vector-collective/ai-wearable/README.md

# ai-wearable

A chest-worn pendant that captures the wearer's conversations, learns who
they are talking to, and feeds a pipeline that reports on the wearer's own
conduct and mood — per relationship, over time. Personal use, one wearer.

| | |
|---|---|
| [`docs/SPEC.md`](docs/SPEC.md) | what it does and how the pieces split — read this first |
| [`firmware/`](firmware/) | XIAO ESP32S3 Sense: three mics, camera, SD, BLE; the capture side |
| [`hardware/`](hardware/) | two enclosures — a resin-printed medallion and a sewn leather pouch |
| [`pipeline/`](pipeline/) | the server side: diarization, transcription, analysis, approval queue (scaffold) |

The pendant captures and triggers; a phone relays; a home server thinks. The
split is forced by the microcontroller, and the hybrid new-voice trigger in
the spec is what lets the whole thing degrade rather than die when any link
in that chain is slow or gone.

## Firmware tests

Host-side, no toolchain needed:

```
bash firmware/test/run.sh
```

Covers the mic source selection, the case UI state machine, photo upload
pacing, the burst policy, time sync, the event ring, the high-pass and
filterbank, the own-voice gate and new-voice detector against synthetic
voices, and the thermal policy. The firmware itself
builds with PlatformIO (`firmware/platformio.ini`).
