vector-collective/ai-wearable/hardware/medallion/renders/face.png

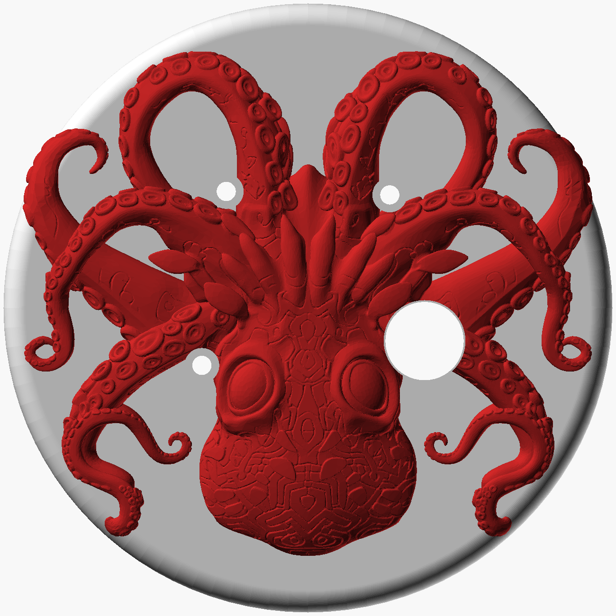
hardware/medallion/renders/face.png
