vector-collective/ai-wearable/hardware/medallion/renders/iso.png

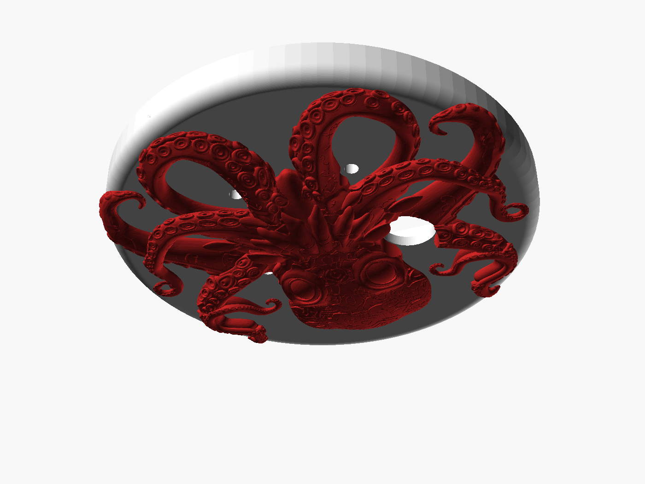
hardware/medallion/renders/iso.png
