vector-collective/ai-wearable/hardware/medallion/renders/rim.png

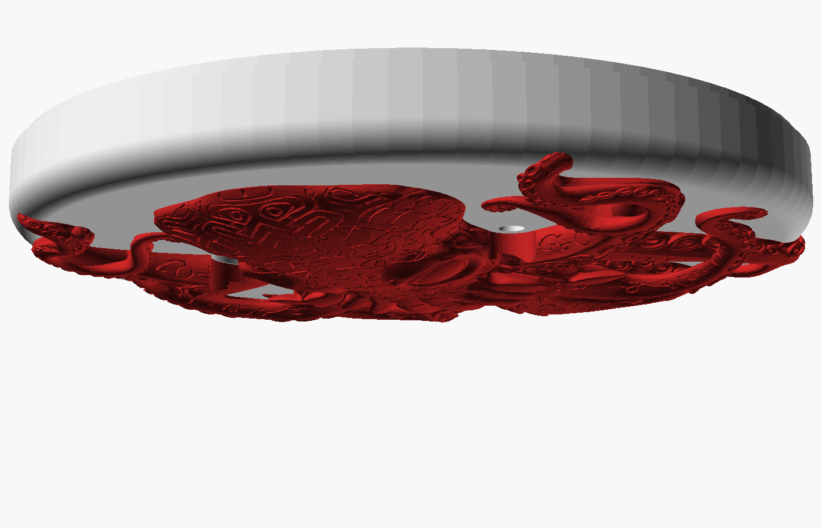
hardware/medallion/renders/rim.png
