vector-collective/ai-wearable/hardware/medallion/renders/toroid_detail.png

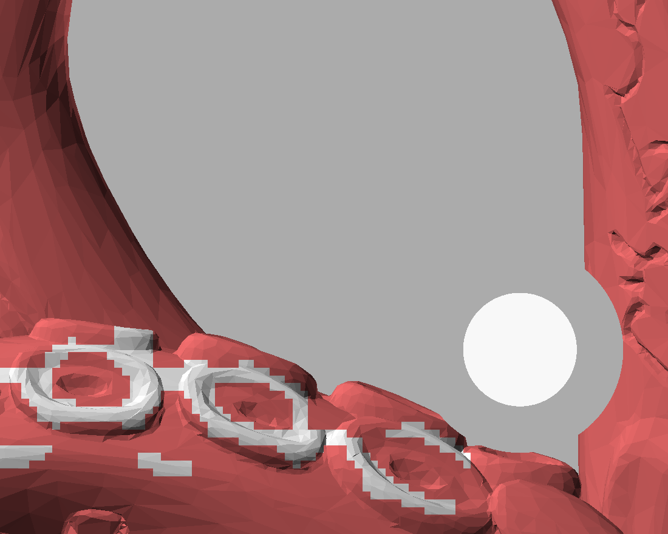
hardware/medallion/renders/toroid_detail.png
