vector-collective/ai-wearable/hardware/medallion/renders/v9_back_ears.png

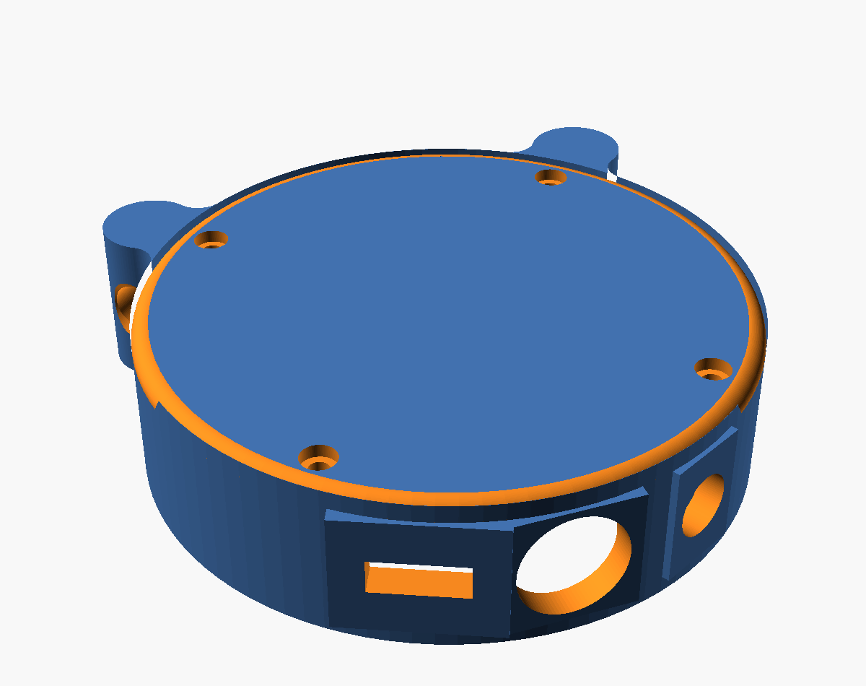
hardware/medallion/renders/v9_back_ears.png
