vector-collective/ai-wearable/hardware/medallion/renders/v9_ear_hole.png

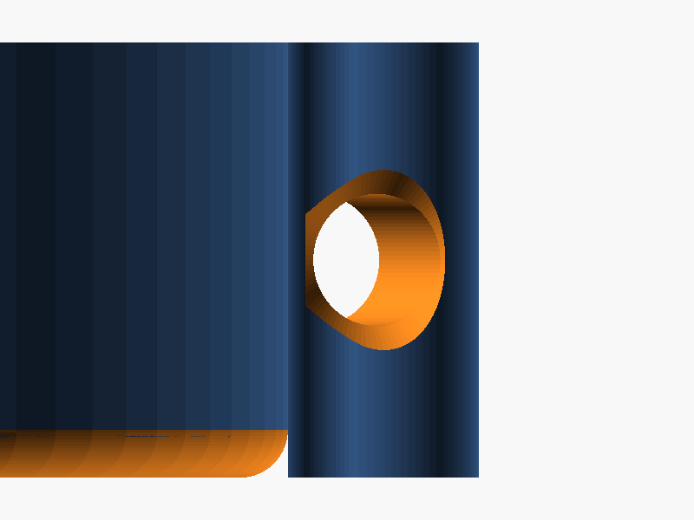
hardware/medallion/renders/v9_ear_hole.png
