vector-collective/ai-wearable/hardware/pouch/renders/worn.png

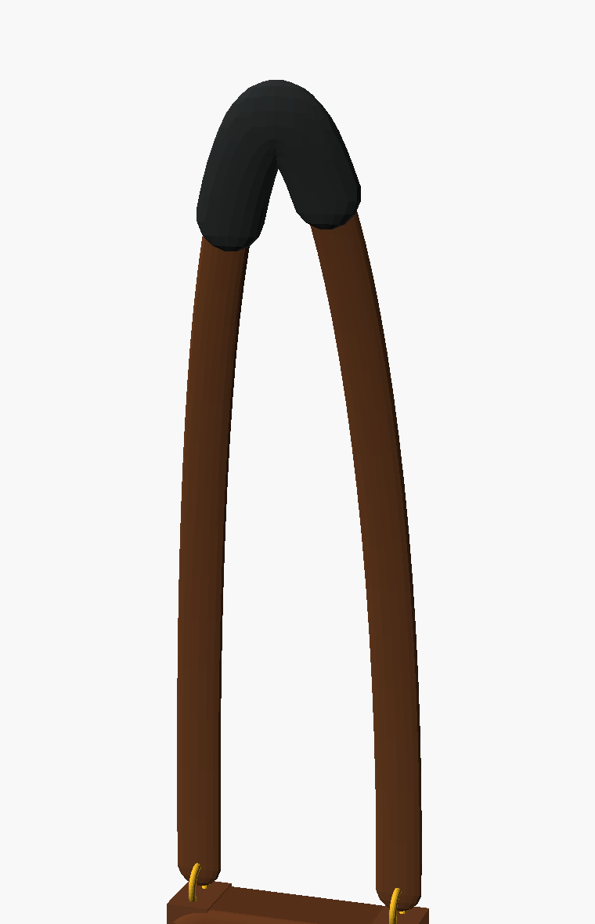
hardware/pouch/renders/worn.png
