vector-collective/ai-wearable/hardware/medallion/front_fused.stl

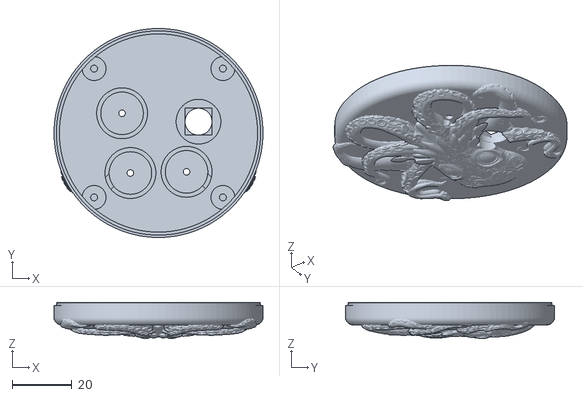
[picture p12: CAD file, 2026-09-10]
hardware/medallion/front_fused.stl
70.0 x 70.0 x 12.1
