vector-collective/ai-wearable/hardware/pouch/template.dxf

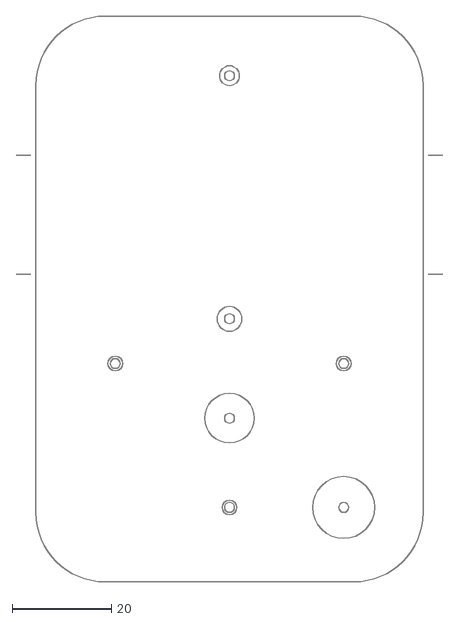
[picture p13: CAD file, 2026-09-06]
hardware/pouch/template.dxf
86.0 x 114.0
