vector-collective/ai-wearable/hardware/medallion/back_shell.stl

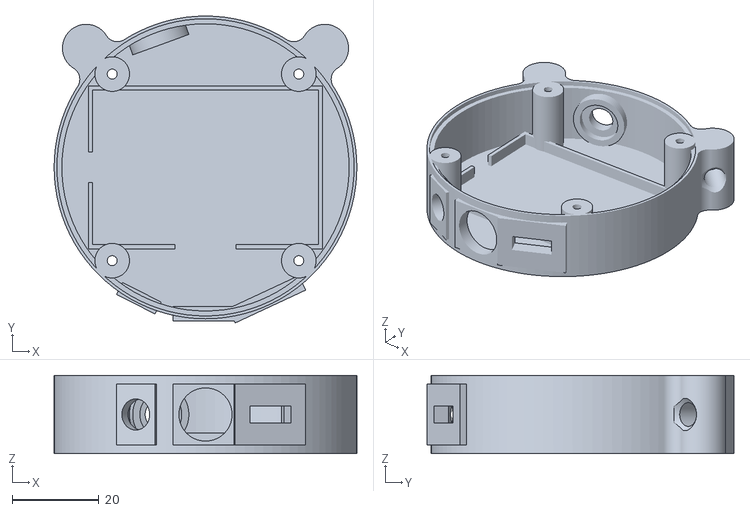
[picture p14: CAD file, 2026-09-10]
hardware/medallion/back_shell.stl
70.0 x 71.0 x 18.1
