vector-collective/ai-wearable/hardware/medallion/front_shell.stl

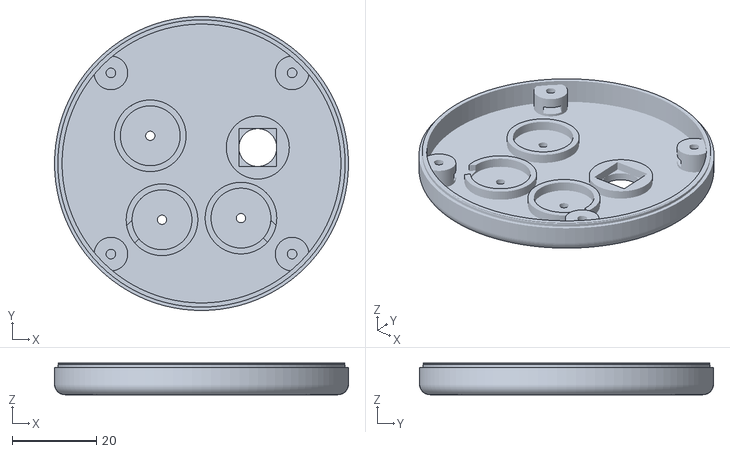
[picture p15: CAD file, 2026-09-10]
hardware/medallion/front_shell.stl
70.0 x 70.0 x 7.50
