vector-collective/ai-wearable/hardware/medallion/kraken_accents.stl

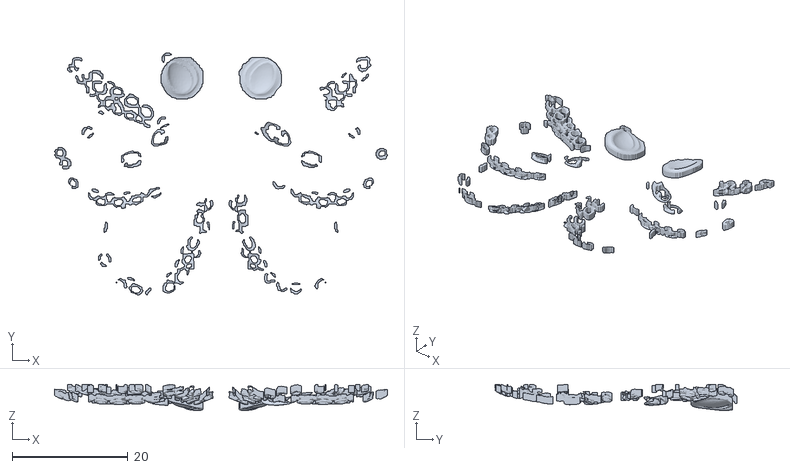
[picture p16: CAD file, 2026-09-04]
hardware/medallion/kraken_accents.stl
57.6 x 41.8 x 4.52
