vector-collective/ai-wearable/hardware/medallion/kraken_body.stl

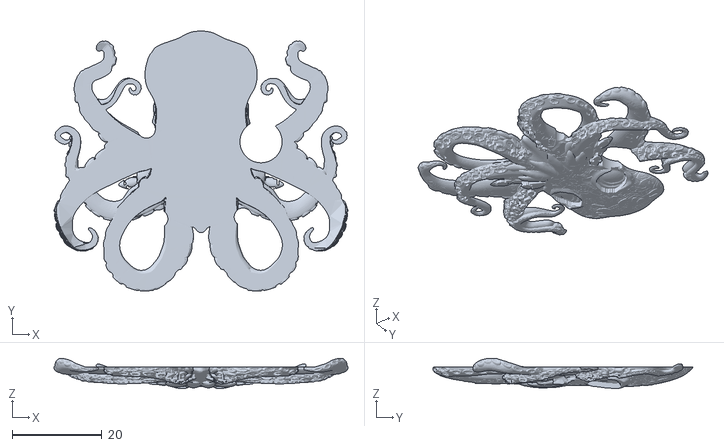
[picture p17: CAD file, 2026-09-04]
hardware/medallion/kraken_body.stl
65.6 x 58.0 x 6.77
