vector-collective/ai-wearable/hardware/medallion/kraken_wrap_bored.stl

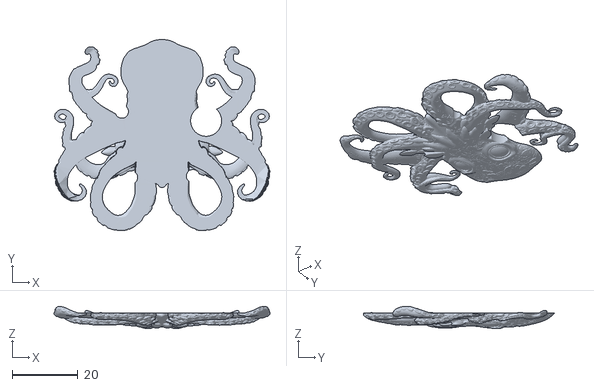
[picture p18: CAD file, 2026-09-04]
hardware/medallion/kraken_wrap_bored.stl
65.6 x 58.0 x 6.77
