vector-collective/ai-wearable/(list of files, cad)

Other CAD files:
hardware/medallion/pendant_case_v7.scad
hardware/medallion/pendant_case_v8.scad
