vector-collective/ai-wearable/hardware/medallion/renders/v9_assembled.png

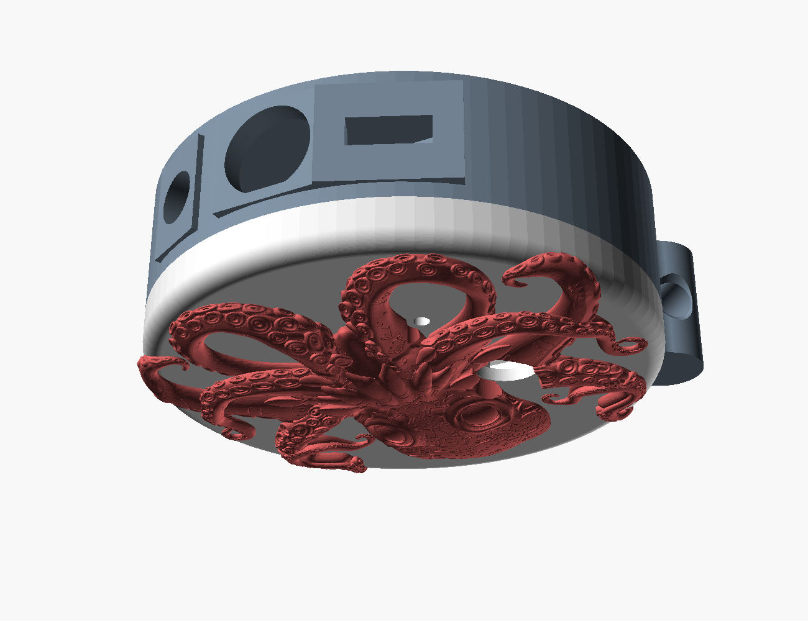
hardware/medallion/renders/v9_assembled.png
