vector-collective/ai-wearable/firmware/src/burst.h

#ifndef BURST_H
#define BURST_H

#include <stddef.h>
#include <stdint.h>

// New-voice photo burst controller. Owns the policy (burst_logic.h), parses
// the CAPTURE_CTRL characteristic, and asks the recorder for frames.

void burst_init();
void burst_loop(uint32_t now);                          // expires hold-offs

// CAPTURE_CTRL write. Ops are in docs/SPEC.md section 3.1.
void burst_handle_ctrl(const uint8_t *data, size_t len);

// The device-tier detector's hook (mic.cpp's novelty detector, via app.cpp).
// score: distance in dB x10 to the nearest known voice, -10 if none known.
// Arms the hold-off; logs EV_CANDIDATE when it does.
void burst_local_candidate(uint32_t hint, int16_t score);

// Thermal hold: no bursts start while set (thermal.h WARM and above).
void burst_set_hold(bool hold);

bool burst_quiet();

#endif // BURST_H
