vector-collective/ai-wearable/(commit log)

2026-08-19 Add quad-INMP441 belt-device firmware (patched omiGlass)
    Patch BasedHardware omiGlass firmware (@1cc793ce2ec9, MIT) for the
    belt-worn capture device: replace the XIAO Sense onboard PDM mic with
    four INMP441s on two standard-mode I2S buses, add per-block source
    selection (optional lapel wins while live, else loudest case mic with
    hysteresis), hot-pluggable lapel via data-line pulldown detection, and
    serial logging of levels and source changes. Opus/BLE pipeline and Omi
    protocol untouched; only src/mic.cpp and src/config.h differ from
    upstream (see firmware/patches/quad-inmp441.patch).
    Claude-Session: https://claude.ai/code/session_012BhN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
    [partitions_ota.csv]
2026-08-19 Add host-side logic tests for mic source selection
    Stub Arduino/I2S/GPIO headers let mic.cpp compile and run on any host
    with plain g++ (./firmware/test/run.sh). Covers channel selection,
    switch hysteresis, lapel takeover and 5s hold-then-fallback, rear-mic
    selection, saturation clamping, and bus-1 failure degradation.
    Claude-Session: https://claude.ai/code/session_012BhN3LnMNn6HhZgrXinjJS
2026-08-22 Add case UI (RGB LED + button) and SD video/audio recorder
    Button state machine: idle short press = battery check shown on a WS2812
    RGB LED (cool-to-warm charge spectrum, red = almost dead); idle long
    press starts recording (start blink doubles as a battery readout);
    short press while recording logs a bookmark and splits the segment;
    long press stops with a double blink colored by SD free space.
    Recorder writes JPEG frames + per-segment WAV with crash-safe header
    patching and a bookmarks.csv to session folders on the Sense microSD.
    Mic bus 0 moves to D5/D6/D7 (GPIO6/43/44) because GPIO7/8/9 are
    hardwired to the SD slot; WS2812 data and the battery divider share
    GPIO2. Status LED writes are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
    [app.cpp, app.h, config.h, recorder_util.h, sd_recorder.cpp, sd_recorder.h]
2026-08-22 Raise record long-press to 1.5s as a guarded control
    Recording is a deliberate, rarely-used function on a small stiff button;
    a 1.5s hold makes accidental starts from furniture or clothing contact
    effectively impossible.
    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
    [config.h]
2026-08-22 Fix audio-path stalls, battery gauge, and bus-1 dropout handling
    From a firmware review pass:
    - Camera fb_count 1 -> 2 and skip recorder grabs while the BLE photo path
    holds a buffer. With one buffer an in-flight photo upload made every
    recorder grab block on the camera's 4s acquire timeout, killing audio.
    - I2S DMA depth 4 -> 12 buffers (~190ms). At 4 the ring held 64ms, less
    than the 100ms read block, so any SD or BLE stall dropped samples.
    - readBatteryLevel: drop 100ms of delay() from the audio path, read via
    analogReadMilliVolts (picks up eFuse ADC calibration), and apply this
    build's 2:1 divider instead of the inherited 6.086 ratio, which pinned
    the reported battery level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
    [app.cpp, app.h, config.h, mic.cpp, recorder_util.h, sd_recorder.cpp, ui.cpp]
2026-08-22 Separate LED and battery-ADC pins; drop the expansion base
    An electrical review found the Seeed Expansion Board Base is not a passive
    battery holder: it hardwires a buzzer to A3, a user button to D1, an
    OLED/RTC I2C bus to D4/D5 and its own microSD chip-select to D2, which
    collides with the LED node and all of mic bus 1. It was only ever in the
    design to avoid soldering the battery; the battery now solders to the
    XIAO's own B+/B- pads and the base is gone.
    Sharing GPIO2 between the WS2812 data line and the battery divider was
    also unsound - with the pad in ADC mode the divider holds the LED's data
    input at VBAT/2, dead centre of its forbidden band, so the latched colour
    was undefined. The d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
    [app.cpp, config.h, ui.cpp]
2026-08-22 Split always-on audio from toggled video; raise camera quality
    Architecture per the agreed model: audio capture and BLE transcription run
    unconditionally from boot and are never gated by the button. The button
    toggles a video session, and audio is written to SD only while one is
    running, so the two can be joined afterwards.
    - Recorder moves into its own FreeRTOS task fed by a stream buffer. Camera
    grabs and SD writes routinely stall for 100-500ms; they can no longer
    block audio capture. Dropped audio bytes are counted and reported at
    session end rather than lost silently.
    - Camera is initialized on session start and deinitialized on stop, so it
    costs nothing during always-on audio.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
    [app.cpp, app.h, config.h, mic.cpp, sd_recorder.cpp, sd_recorder.h, ui.cpp]
2026-08-22 Refresh docs to match current design; add CI
    - Regenerate patches/quad-inmp441.patch against upstream: it covered only
    the original two-file mic patch and now spans all 11 changed files.
    - README: rewrite the header and change summary around the always-on audio
    / toggled video split, the recorder task, and the camera lifecycle; note
    that the camera is untouched at boot.
    - config.h: drop the inherited '6-8 hours' framing and document why the
    light-sleep path is unreachable and deliberately left that way (it would
    gate APB out from under a running I2S peripheral).
    - mic.cpp: header comment now states the selection order and why case
    changeover is gated to near-silence.
    - Add GitHub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
2026-08-22 Use the full 8MB flash; drop dead header; de-duplicate CI runs
    The first real cross-compile (CI) reported Flash at 95.5% - 83kB of
    headroom. The cause was the inherited partition table, which allocated
    only the first 4MB of the board's 8MB flash and so capped each OTA slot at
    1.75MB. The table now spans the whole chip: 3.625MB per app slot and 704kB
    of SPIFFS, taking the firmware to roughly 46% of its partition. Flash size
    is stated explicitly in both build environments.
    Also removes src/camera_index.h - 154kB of upstream camera-web-UI source
    that nothing includes (it was dead source, not dead flash) - and stops the
    CI workflow running twice per push by triggering on master pushes plus
    pull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
    [partitions_ota.csv]
2026-08-22 Short press stops capture; compile out the lapel path entirely
    Button semantics per the agreed scheme: idle short press = battery
    readout, idle long press (1.5s) = start AV capture, and EITHER press
    while recording stops it. Previously a short press while recording
    logged a bookmark and split the segment; that gesture is now stop, so
    the bookmark/segment-split path is removed along with bookmarks.csv.
    Long-press-while-recording also stops rather than being a dead gesture -
    starting remains the guarded action, ending does not need to be.
    The LED stays off except while showing a readout, which was already the
    behavior and is now stated in the README.
    Phase 1 ships without the lapel pod, so M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
    [mic.cpp, sd_recorder.cpp, sd_recorder.h, ui.cpp, ui_logic.h]
2026-08-22 Add a dim recording heartbeat every 30s
    While a capture session is running the LED now gives a single dim blink
    in the battery colour every 30 seconds, so a session left running is
    discoverable at a glance and the colour says whether the cell will carry
    it to the end. Outside that the LED remains dark except for readouts.
    The heartbeat only fires when the pattern engine is idle, so it can never
    truncate a battery or SD readout; if one is showing when the heartbeat
    falls due it lands as soon as that finishes. The timer resets whenever
    recording stops, so the first heartbeat of a session is a full interval
    after it starts rather than immediately.
    ui_dim() keeps at least one unit of any chann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
    [config.h, ui.cpp, ui_logic.h]
2026-08-22 Battery readout becomes 5 blinks; blink count identifies the reading
    A quick press does one of two things depending on state, and both use the
    same cool-to-warm colour spectrum, so the count now disambiguates them:
    five blinks is a battery reading (device was idle), two is a stop
    confirmation showing SD space remaining (device was recording). The stop
    case was already two blinks; the battery readout changes from a 2s solid
    to five blinks.
    Removes the now-unused solid pattern rather than leaving a dead static
    function to warn at build time - every readout is a blink count in a
    colour, so the pattern engine only needs the one mode.
    Claud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
2026-09-04 Add the pendant enclosure CAD: kraken medallion rev v7
    The case has lived only in a scratchpad until now. This lands the design
    of record plus everything needed to regenerate it.
    The arms wrap the rim. The sculpt is a flat-backed relief with no
    geometry below its back plane, so scaling it until the arms reach the
    edge makes them overhang, not grip. build_kraken.py bends the mesh
    instead: each vertex becomes (footprint, height above the back plane),
    the footprint is re-projected onto the case's real outer surface - flat
    disc, 2.5mm rim fillet, then the r=35 cylinder - and the height is
    re-applied along that surface's local normal. Arms now run 1.95mm down
    the side, 0.83mm proud of the rim, s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
    [back_shell.stl, front_shell.stl, kraken_wrap_bored.stl, pendant_case_v7.scad]
2026-09-04 Print the eyes and sucker rings in the shell material
    The relief becomes two complementary solids - 4.537 + 0.475 = 5.013 cm3,
    exactly the whole relief - so a slicer treats them as one object with two
    materials rather than two parts that have to be aligned. Body is a single
    solid; accents are 41 islands, the two eyes plus the ring runs along each
    arm. Needs an MMU/AMS: the accents sit at ~100 different heights, so no
    single Z exists at which a manual filament swap could produce them.
    Meshy exports carry no per-feature tags, so both features are found from
    the geometry. A ring matched filter over five radii locates each sucker
    and a mask-normalised Gaussian high-pass supplies the exact ring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
    [kraken_accents.stl, kraken_body.stl, pendant_case_v8.scad]
2026-09-04 Trace the real sucker toroids instead of synthesising rings
    The accent rings did not line up with the sculpted suckers. Cause was the
    ring-closing step: an analytic annulus at the detected radius was unioned
    in to close the arcs the high-pass only partially caught. On an obliquely
    viewed arm a synthetic circle sits off the real toroid, so the white ring
    and the sculpted ring visibly disagreed.
    Now the toroid itself is traced. A ray is walked out at each of 128
    angles and the crest is taken where the high-pass peaks along it, so the
    ring follows the true sculpted geometry whatever its shape, and closes by
    construction because every angle contributes. A candidate survives only
    if it has a cre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
    [kraken_accents.stl, kraken_body.stl]
2026-09-06 Add the sewn pouch and split hardware by container
    hardware/case became hardware/medallion, and hardware/pouch joins it, with
    an index at hardware/README.md saying which to build and when. They are
    alternatives for the same electronics, not stages of one thing.
    The pouch is a bound-edge, three-panel design: front and flap cut as one
    piece of veg-tan so there is no seam at the fold, back and gusset in soft
    laminate that eases round the R14 corners and is what touches skin.
    Finished 78 x 62 x 24, giving a 22mm cavity against the measured 20.2mm
    stack. Every piece is cut to finished size - the edges are bound, so
    there is no seam allowance anywhere.
    pattern.py generates two 1:1 cutting sheets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
    [back_shell.stl, front_shell.stl, kraken_accents.stl, kraken_body.stl, kraken_wrap_bored.stl, pendant_case_v7.scad, pendant_case_v8.scad, pouch_mk1.scad]
2026-09-06 Fix the GPIO21 chip-select race and the photo upload throttle
    Two defects, both in code whose comments describe the behaviour it was
    meant to have rather than the behaviour it had.
    GPIO21 is simultaneously the SD chip select and the onboard LED, and the
    LED writer guarded on sd_recorder_mounted(). But `mounted` is not set
    until SD.begin() RETURNS, so the whole duration of the mount - tens to
    hundreds of milliseconds of SPI traffic with GPIO21 as an active chip
    select - read as "LED still free", and the main loop was at liberty to
    drive the pin straight through the transaction it was clocking. That is
    not a narrow race; the unguarded window is exactly the operation that
    must not be disturbed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
    [app.cpp, config.h, photo_logic.h, sd_recorder.cpp, sd_recorder.h]
2026-09-07 Add the system spec for the speaker-aware pivot
    Memory recall leaves this project; it will run elsewhere on this
    project's transcripts. In its place: speaker identity, a new-voice photo
    burst, per-relationship trends, self-analysis, action-item extraction
    behind an approval queue, and an activity log.
    The spec fixes the architecture the ESP32-S3 forces - the pendant
    captures and triggers, a phone relays, a home server thinks - and the
    hybrid trigger that makes it degrade rather than die: the device arms a
    hold-off on its own candidate detection, a remote verdict inside the
    hold-off wins, and silence means the device fires on its own authority.
    The hold-off IS the latency policy; nothing mea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
2026-09-07 Medallion v9: resin retune and two cord lugs (in progress)
    First unit prints on a Creality Halot-Mage 8K in a rigid photopolymer,
    which changes three things that are not cosmetic. Heat-set inserts are
    a thermoplastic technique and cannot be set in a thermoset - the front
    bosses are now tapped M2 directly in the resin (1.65 pilot, 7.0 boss).
    FDM printed holes 0.1-0.4 undersize and the file carried +0.6 for it;
    an 8K mono LCD undersizes by light bleed alone, ~0.1, so the allowances
    drop to ~+0.25 and the spigot clearance to 0.06 per side. And a resin
    printer is one material, so the relief defaults to the single piece with
    the body/accents split kept behind a flag for MMU printers.
    The single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
    [pendant_case_v9.scad]
2026-09-07 Medallion v9: resin build, two cord ears, three reviews folded in
    First unit prints on a Halot-Mage 8K in a rigid photopolymer. Three
    parallel reviews - resin printability, mechanical/assembly, electronics
    fit - went into this revision. What they changed, and why:
    Fastening. Heat-set inserts are a thermoplastic technique and cannot be
    set in a thermoset. Tapping M2 into the resin was rejected by two of the
    three reviews for a case opened every battery swap: 3-5 cycles and it
    strips or cracks. A DIN 934 M2 nut drops into a hex pocket (4.25 AF x
    1.8) at the top of each front boss, the back boss face covers it, and an
    M2x20 button head comes through from the back. Load on the resin is pure
    com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
    [back_shell.stl, front_fused.stl, front_shell.stl, pendant_case_v9.scad]
2026-09-07 Add time sync, the event timeline, and the new-voice photo burst
    The capture side of docs/SPEC.md, so the data the pipeline needs exists
    before the pipeline does.
    Time. There is no RTC. The phone writes Unix epoch milliseconds to a new
    TIME_SYNC characteristic on every connect; the device keeps the pair
    (epoch, millis-at-sync) and maps wall time from millis() in uint32
    arithmetic, which stays correct across the 49.7-day wrap. An NVS boot
    counter makes millis meaningful across power cycles. Every event carries
    (boot_id, millis, epoch-or-0) and every sync is itself an event, so the
    pipeline can rebuild the mapping per boot from anchors alone.
    Timeline. A 64-entry ring (event_ring.h, host-tes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
    [app.cpp, burst.cpp, burst.h, burst_logic.h, config.h, event_ring.h, events.cpp, events.h]
2026-09-08 Own-voice gate, device-tier new-voice detector, 110 Hz high-pass, thermal throttle
    The device tier of the hybrid trigger (docs/SPEC.md 2.1) now exists and is
    wired: mic.cpp's novelty detector arms the burst hold-off through
    burst_local_candidate(), and every candidate lands on the timeline with its
    score so the thresholds can be set from real wear rather than guessed.
    Mic path (mic.cpp, voice_dsp.h, voice_logic.h):
    - every channel present is converted to int16 and high-passed at 110 Hz
    before the level metric and before the stream leaves the device; the
    selector no longer keys on clothing rumble and Opus stops paying for it
    - MIC_BIT_SHIFT 14 -> 16: the int16 now holds the mic's top bit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
    [app.cpp, burst.cpp, burst.h, config.h, event_ring.h, mic.cpp, mic.h]
2026-09-10 Medallion v9.1: captured nut moves into a side-entry slot under a ceiling
    A question about which M2 nuts to buy exposed a load-path defect in the v9
    fastening. The nut sat in a hex pocket open to the parting face, covered
    by the back shell's boss. A screw from the back pulls its nut toward the
    head, so the nut lifted its 0.2 of play and bore on the BACK shell: head,
    back shell and nut were the whole load path, and the front shell was held
    by spigot friction alone. It would have felt tight.
    The pocket becomes a slot entered from the boss's cavity side, 4.25 wide x
    1.8 tall, with 2.3 mm of resin above it. The nut now pulls up against the
    front shell and the shells clamp together. The head cou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
    [back_shell.stl, front_fused.stl, front_shell.stl, pendant_case_v9.scad]
2026-09-10 Medallion README: the two-part front in a second resin
    Which files to print, that the relief is unchanged by v9.1, the measured
    13 mm3 arm-to-rim skim with the relief on the face rather than sunk, and
    what the second resin has to be (opaque; rigid is fine for the relief).
    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
